hgducharme/inverted-pendulum/demo/pictures_and_videos/assumptions.PNG

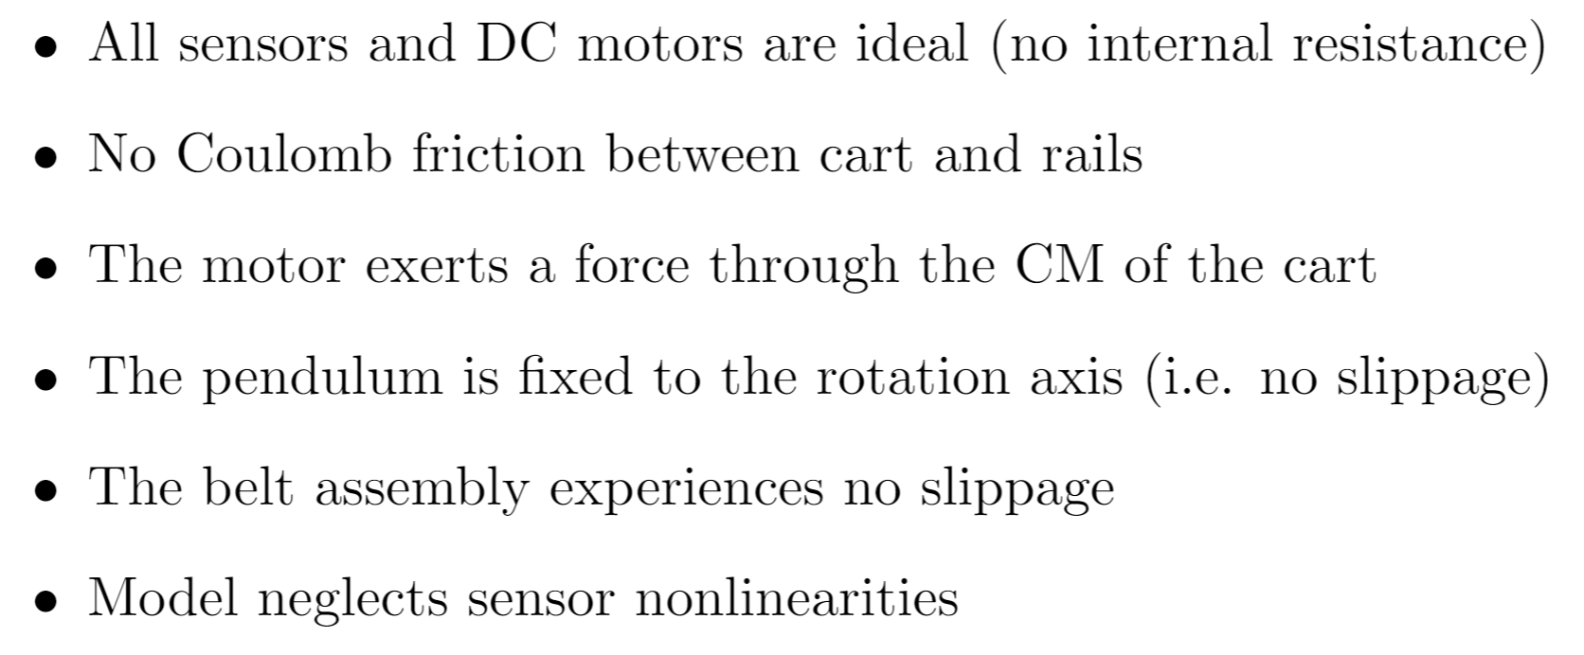
demo/pictures_and_videos/assumptions.PNG
