hgducharme/inverted-pendulum/demo/pictures_and_videos/cart_screw_holes.jpg

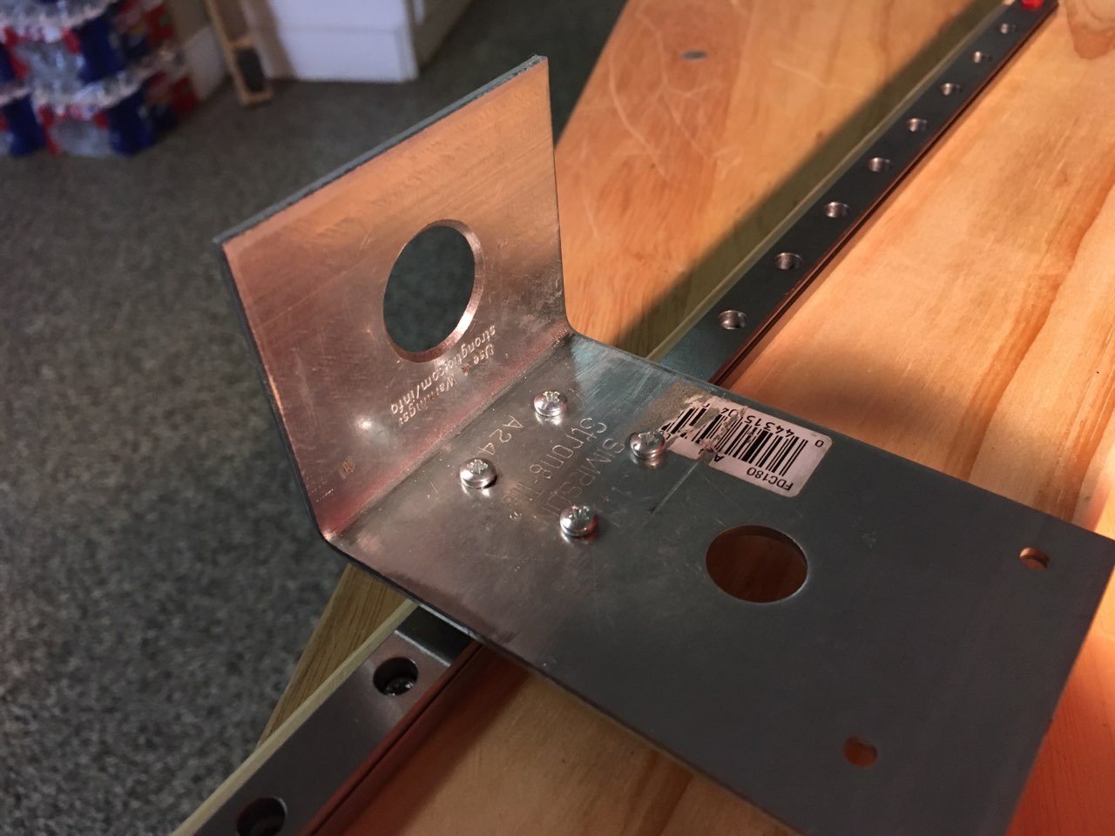
demo/pictures_and_videos/cart_screw_holes.jpg
