hgducharme/inverted-pendulum/demo/pictures_and_videos/graphsLQR.png

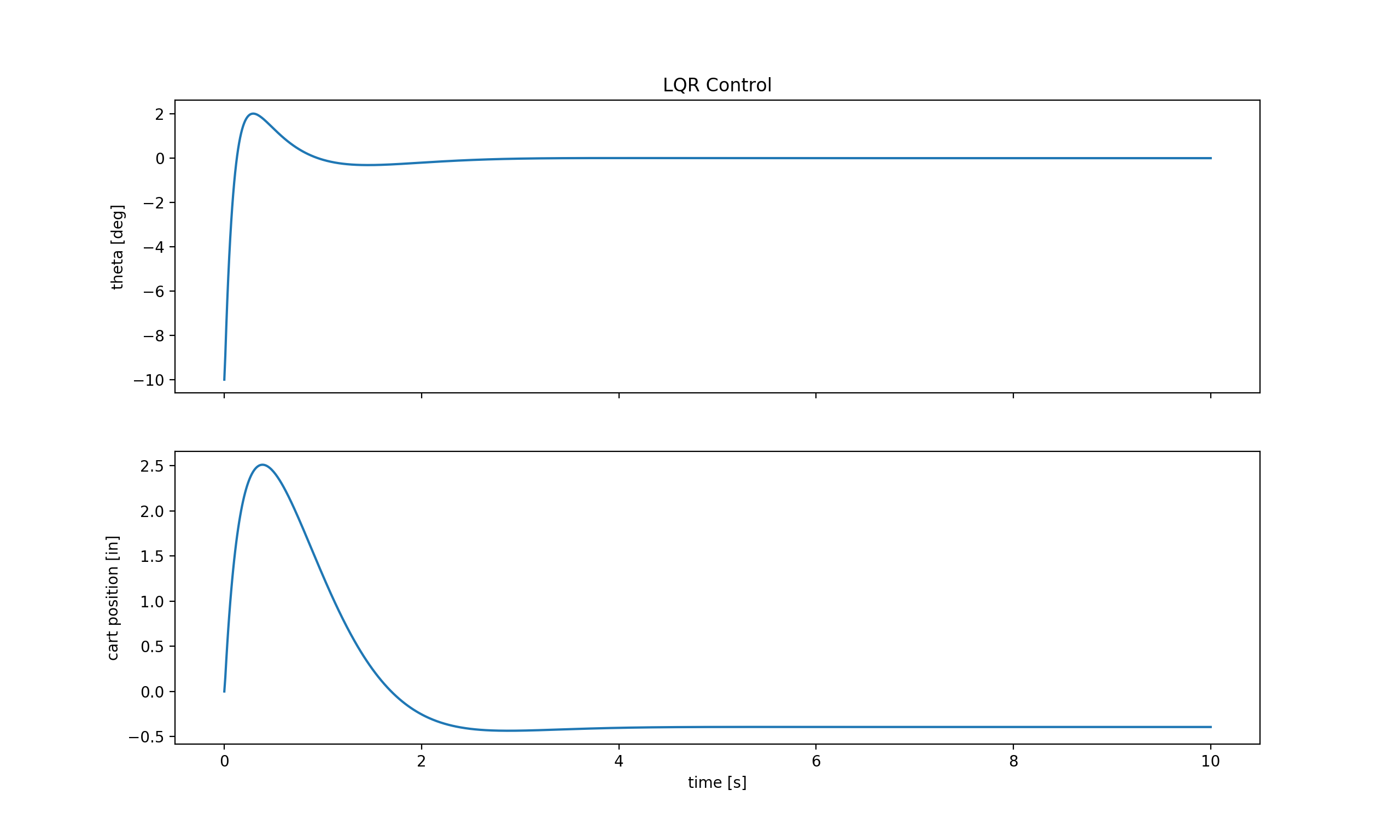
demo/pictures_and_videos/graphsLQR.png
