hgducharme/inverted-pendulum/demo/pictures_and_videos/holed2By4.jpg

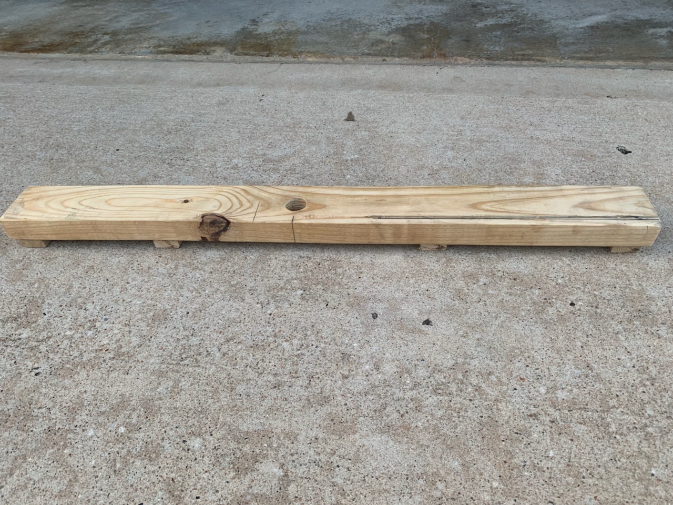
demo/pictures_and_videos/holed2By4.jpg
