hgducharme/inverted-pendulum/demo/pictures_and_videos/initalQR.PNG

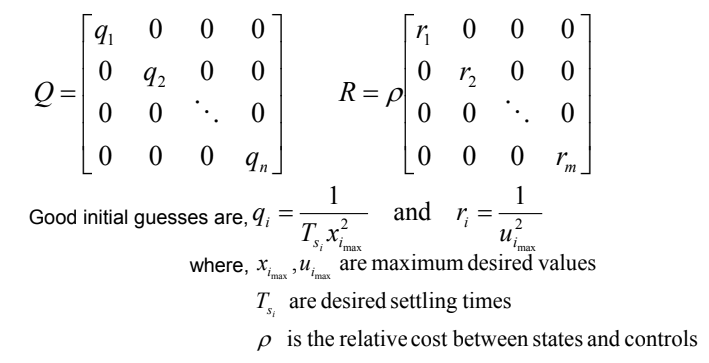
demo/pictures_and_videos/initalQR.PNG
