hgducharme/inverted-pendulum/demo/pictures_and_videos/mustard.jpg

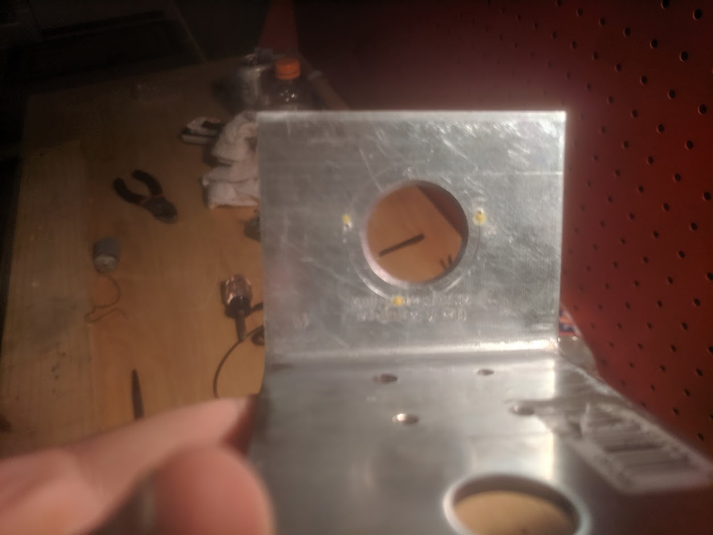
demo/pictures_and_videos/mustard.jpg
