hgducharme/inverted-pendulum/demo/pictures_and_videos/naturalResponseGraphs.png

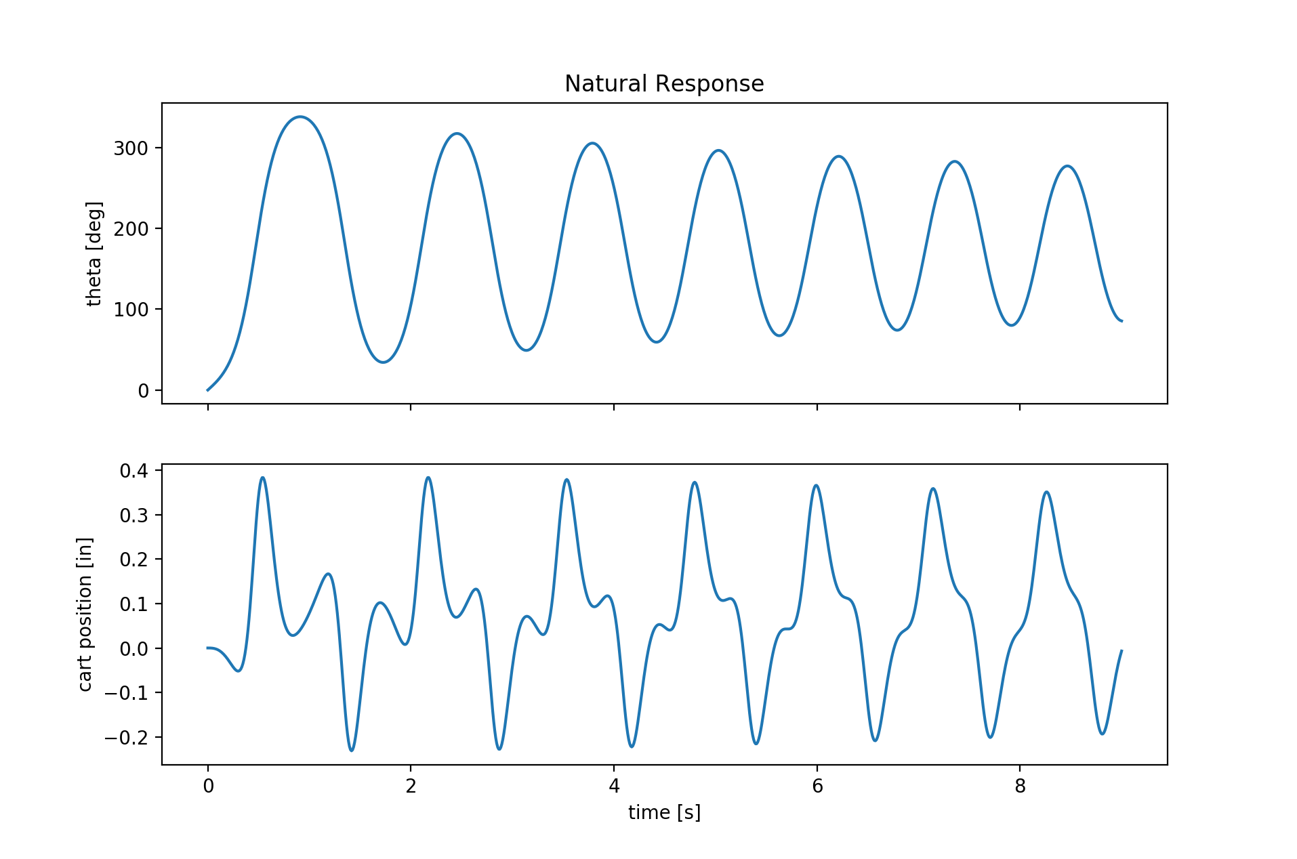
demo/pictures_and_videos/naturalResponseGraphs.png
