hgducharme/inverted-pendulum/demo/pictures_and_videos/rails_and_cart.jpg

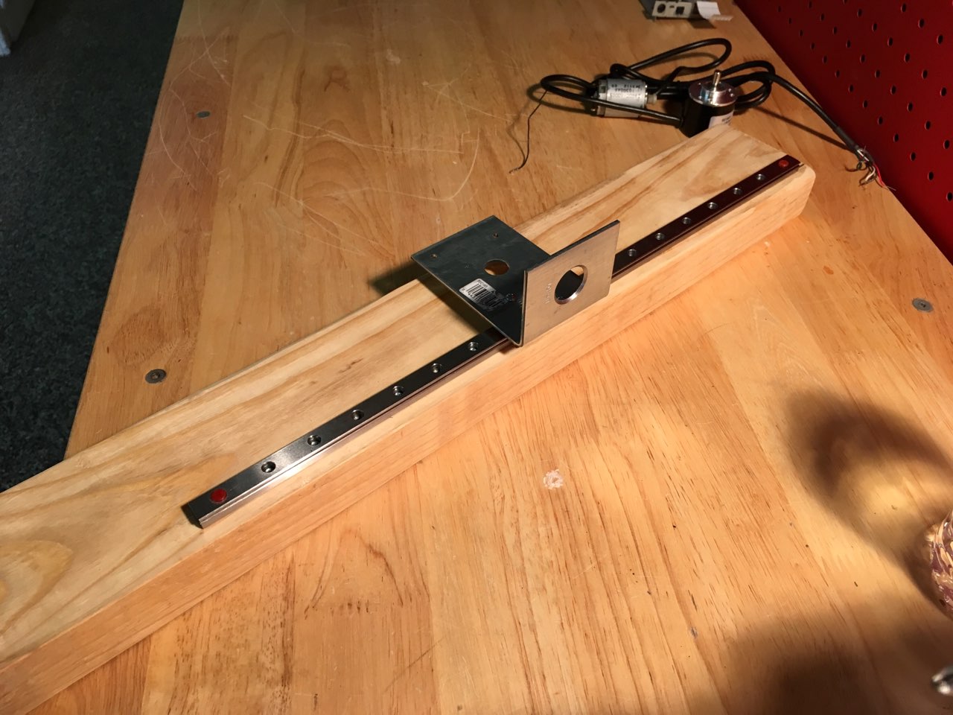
demo/pictures_and_videos/rails_and_cart.jpg
