hgducharme/inverted-pendulum/demo/pictures_and_videos/sheetMetal.jpg

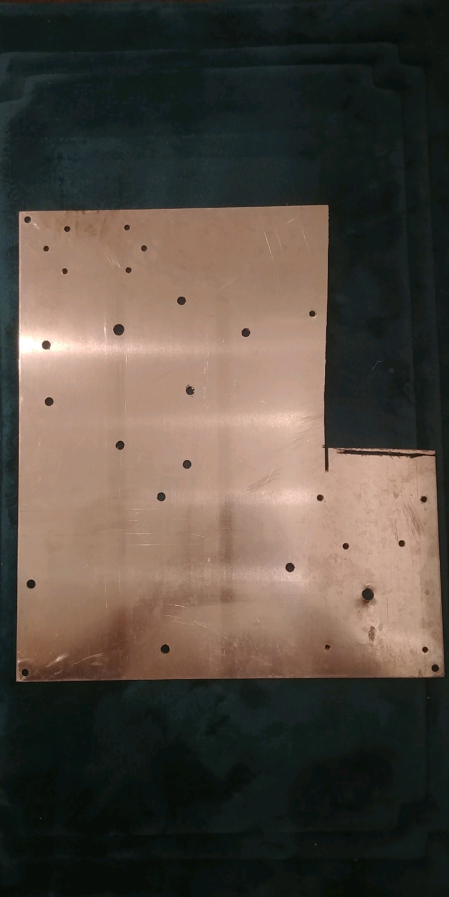
demo/pictures_and_videos/sheetMetal.jpg
