hgducharme/inverted-pendulum/demo/pictures_and_videos/bare_printer.jpg

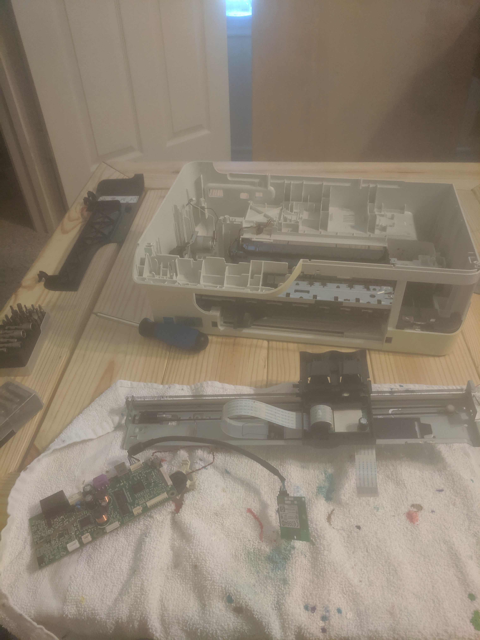
demo/pictures_and_videos/bare_printer.jpg
