hgducharme/inverted-pendulum/demo/pictures_and_videos/finalBuild.jpg

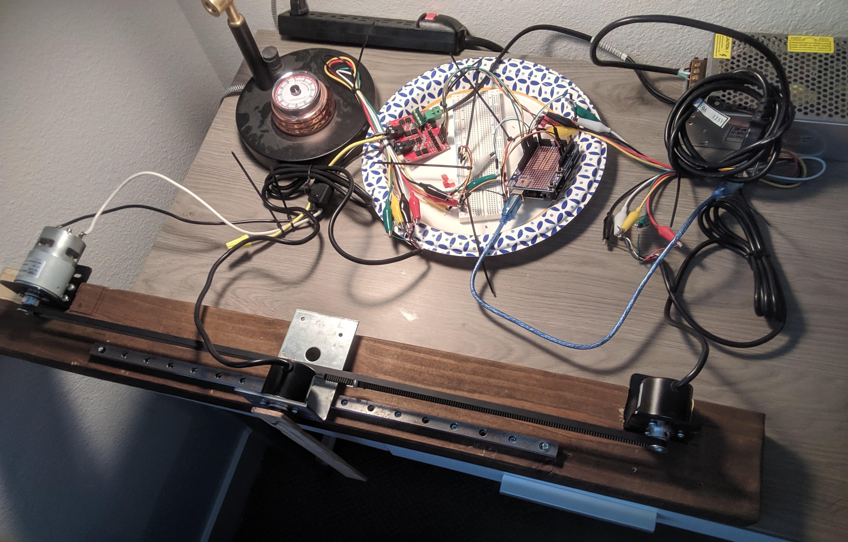
demo/pictures_and_videos/finalBuild.jpg
