hgducharme/inverted-pendulum/demo/pictures_and_videos/picture_of_starting_setup.png

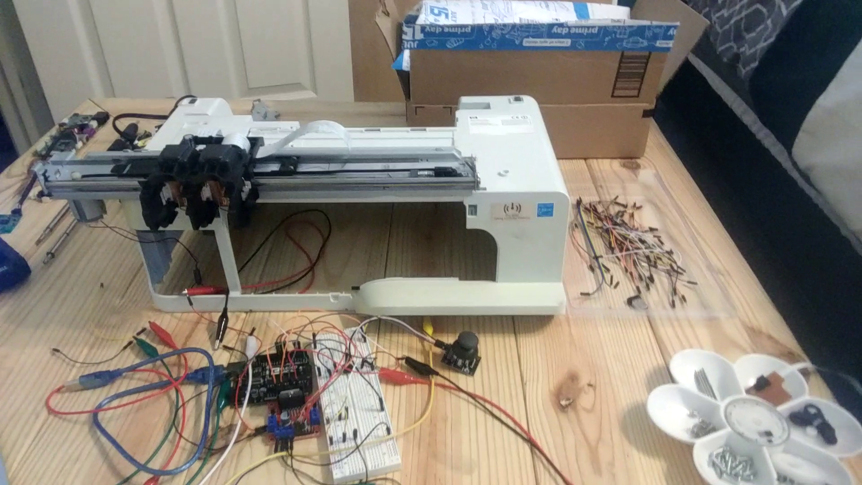
demo/pictures_and_videos/picture_of_starting_setup.png
