hgducharme/inverted-pendulum/(commit log)

2019-08-18 Complete overhaul of arduino folder
    I migrated from arduino IDE to vscode using PlatformIO. Took a little bit of time but here is the new project directory. Probably doesnt make sense to have a .gitignore inside the arduino folder but whatever, ill change it later. Note: the arduino folder has to be the first folder in the vscode workspace, otherwise imports dont work for some reason.
2019-08-19 got vscode setup with hardware
    worked all day on controlling the motor and measuring motor specs. I think I need to get a better motor controller cause it doesnt seem to be as response as the L298N
2019-08-20 committing for backup sake
    Making some progress on sending data from arduino to python. Im committing so I can backup what it looks like to use interrupts with the rotary encoder. I think im going to move from using interrupts to just operating on a discrete timeframe, like reading and sending the data to python every 0.1 seconds or something
2019-08-20 getting closer
    I was wrong. We dont want to get rid of interrupts because thats how we keep track of our encoder changes. What I was trying to say is that we dont need to check if the current value has changed from the previous value. That was just in place to not clutter the serial, but now that we print every specified timeframe that will do the job.
    [main.cpp]
2019-08-24 can now send the state from arduino to python
2019-08-24 Can now read and write to arduino
    Still buggy though. This needs to be worked out and I need to figure out how to increase communication speed
2019-08-29 Improved arduino to python communication
    Made the communication between arduino and python better and more robust. Instead of parsing the arduino values by new line ("\n"), the function now takes a specified start and end character to look for in a data packet.
2019-08-31 Getting closer!
    This setup is really close. I increased the baud rate a little bit and played around with the following variables: TIMEFRAME and the mapping function. Changing these two variables can do a lot to the system. However, Im going to start working on migrating entirely to C++. The python code really isnt doing anything super expensive that the arduino cant do. If I was implementing a kalman filter then sure, using python might be a bit more justified, but right now I cant seem to justify it.
2019-09-01 migrated LQR to C++
    Completely migrated all controller code to C++. The very first run after this was SO much faster/smoother than the python code. 100ms loop time is wayyyyy too slow. Right now the pendulum is very close to being stable. Its a matter of tuning the LQR controller and finding what to penalize. However, I have to be super careful with how much actuator effort I use because the motor can spike above 10A. Ive already blown like 9 fuses today because of it
    [main.cpp, pythonUtils.h, simulation_and_design.py, utilsLQR.h]
2019-09-02 turns out my model was right!
    Someone on reddit helped point out that my cart position was backwards. Turns out I was using the control law u = Kx when I should have been using u = -Kx. However I still need to find out how to get rid of this oscillatory motion.
    [main.cpp, simulation_and_design.py, utilsLQR.h]
2019-09-03 updated test motor
2019-10-28 switched image tag
2019-10-28 switched image tag back and centered images
2019-10-28 deleted MATALB files
    The MATLAB files were from the very early stages and arent worth keeping. The code can all be found in the python file and the simulkink model was extremely basic
